isadrak/SDE-Station/boitier/stl/sde-corps.stl

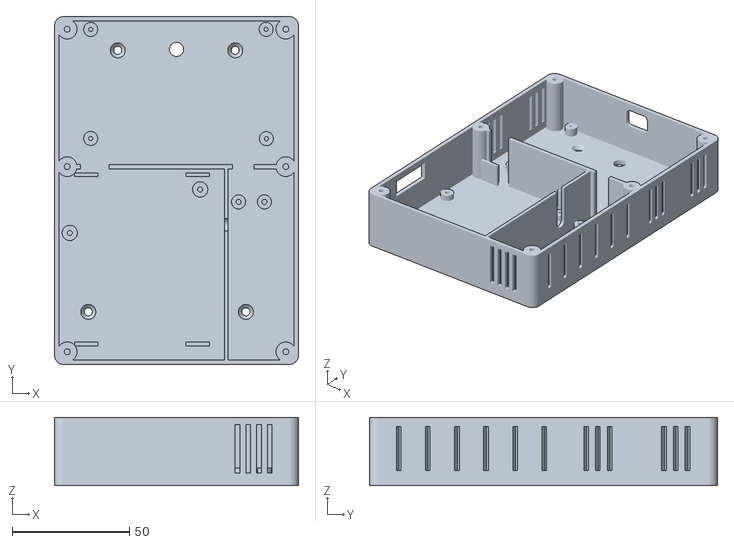
[picture p15: CAD file, 2026-10-29]
boitier/stl/sde-corps.stl
103.8 x 148.1 x 29.1
