isadrak/SDE-Station/boitier/stl/sde-socle.stl

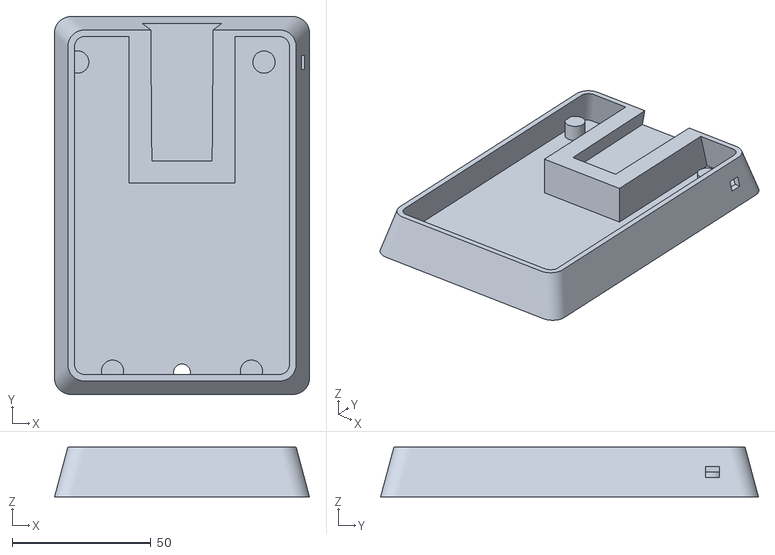
[picture p16: CAD file, 2026-10-29]
boitier/stl/sde-socle.stl
91.8 x 136.1 x 18.0
