isadrak/SDE-Station/boitier/stl/sde-pied.stl

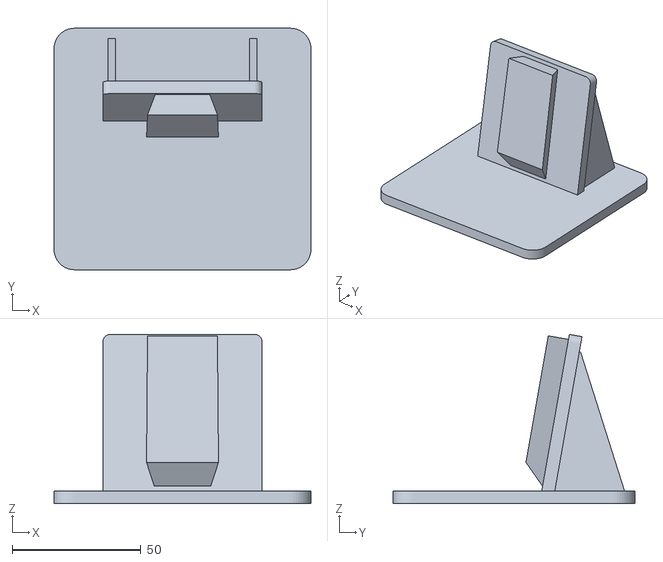
[picture p17: CAD file, 2026-10-25]
boitier/stl/sde-pied.stl
100.0 x 94.0 x 65.9
