isadrak/SDE-Station/boitier/stl/sde-capot.stl

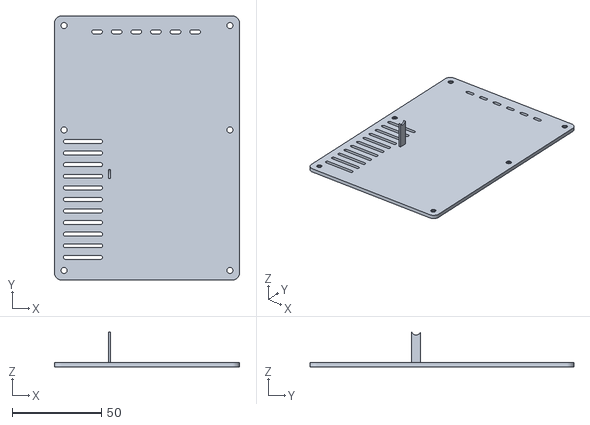
[picture p18: CAD file, 2026-10-25]
boitier/stl/sde-capot.stl
103.8 x 148.1 x 19.5
