isadrak/SDE-Station/boitier/stl/sde-support.stl

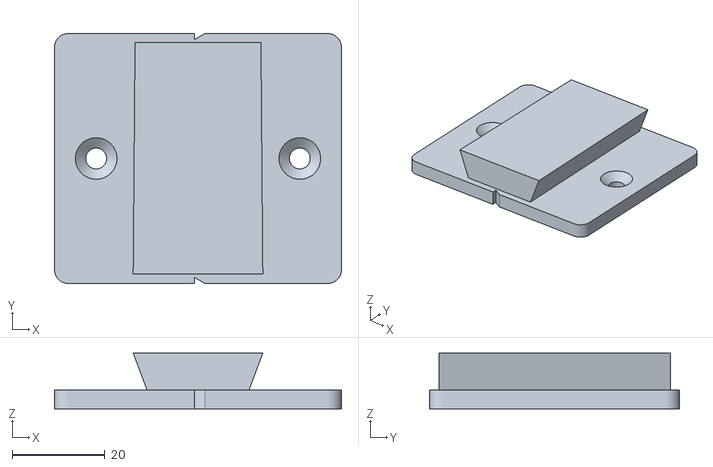
[picture p19: CAD file, 2026-10-25]
boitier/stl/sde-support.stl
62.0 x 54.0 x 12.0
