isadrak/SDE-Station/(commit log)

2026-10-25 SDE : station de diagnostic environnemental (firmware 0.9.8, appli, Android, boîtier)
    [sde-boitier.scad, sde-capot.stl, sde-corps.stl, sde-socle.stl, sde-support.stl]
2026-10-25 CI : erreurs de compilation affichées en annotations
2026-10-25 gen_assets : crée src/web/ s'il n'existe pas
2026-10-25 Firmware : versions des bibliothèques figées (taille du programme)
2026-10-25 CI : compilation avec arduino-cli (même chaîne que les binaires publiés)
2026-10-25 Compilation par firmware/build.sh (arduino-cli), APK joint aux Releases
2026-10-25 CI : notes de Release
2026-10-25 Captures refaites sans la barre d'installation
2026-10-25 README : schéma, routage et vue 3D de la carte KiCad
2026-10-25 README : précision sur la carte
2026-10-25 Images de la carte retouchées (fond retiré, recadrage, schéma compacté)
2026-10-25 Schéma : PWR_FLAG retirés de l'image
2026-10-25 Boîtier refait avec les vraies cotes et pied de table
    Carte tournée (USB en haut), SDS011 mesuré avec sortie dans la paroi
    gauche, chambre d'air frais à droite (buse et BME680), pied de table
    avec le même rail que le support mural.
    [sde-boitier.scad, sde-capot.stl, sde-corps.stl, sde-pied.stl, sde-socle.stl, sde-support.stl]
2026-10-25 Boîtier : trous du BME680 à 6 mm du bord (mesuré)
    [sde-boitier.scad, sde-corps.stl]
2026-10-25 Boîtier : socle imprimé côté plein, biseau sous le rail du pied
    Vérifié au slicer : aucune pièce ne demande de supports.
    [sde-boitier.scad, sde-pied.stl, sde-socle.stl]
2026-10-25 Boîtier : vis M3 directement dans le plastique (sans inserts)
    Option inserts = true pour revenir aux inserts laiton.
    [sde-boitier.scad, sde-corps.stl, sde-socle.stl]
2026-10-29 Boîtier : trou du câble LED déplacé, il chevauchait une vis du socle
    Signalé par l'imprimeur : le fraisage de la vis du socle en haut à droite
    touchait le trou de 6 mm du câble de la bande LED. Le trou passe au centre.
    [sde-boitier.scad, sde-corps.stl, sde-socle.stl]
2026-11-02 Docs : README, guide et notes du boîtier relus et simplifiés
    Guide renuméroté, mentions de versions intermédiaires retirées, notes du
    boîtier réécrites en documentation de projet. Bande LED commandée.
    [sde-boitier.scad]
2026-11-07 Particules : démarrage, pics isolés et air humide écartés de la note [release]
    - Appli : les 10 premières minutes après le démarrage, les pics isolés
    (filtre de Hampel sur 7 mesures) et les mesures à 75 % d'humidité ou
    plus restent affichés mais ne comptent plus dans la note ni dans la
    bande des 24 h. NowCast provisoire calculé sur la médiane. États
    « Stabilisation », « Pic passager », « Faussée par l'humidité ».
    - Firmware 0.9.9 : même règle pour la lumière murale (médiane des 3
    dernières mesures, démarrage et air humide ignorés).
    - Service worker sde-v14, guide et README à jour.
2026-11-07 Graphique des particules : courbe continue, barre de période opaque [release]
    - Les mesures du SDS011 (une par cycle) étaient coupées en points isolés
    dans l'historique : le seuil de trou suit maintenant le cycle.
    - Plus de points sur la courbe, sauf pour une mesure isolée.
    - Barre de période collante opaque : les étiquettes des graphiques ne
    passent plus dessous.
    - Firmware 0.9.10 (appli embarquée), service worker sde-v15.
2026-11-12 Bande LED : nombre de LED réglable dans l'appli, démarrage doux
2026-11-12 Bande LED : extinction de toutes les LED au démarrage, guide de câblage [release]
2026-11-12 Firmware 0.9.11 : bande LED réglable et éteinte au démarrage [release]
2026-11-12 Firmware 0.9.12 : bande LED coupée après des chutes de tension répétées [release]
2026-11-12 Firmware 0.9.13 : animations de la bande LED [release]
2026-11-12 Firmware 0.9.14 : animations LED plus douces, aération alignée sur l'appli, envoi RMT fiabilisé [release]
2026-11-12 Firmware 0.9.15 : barre de mise à jour sans ralentir l'écriture en flash [release]
2026-11-12 Firmware 0.9.18 : mise à jour par Wi-Fi de nouveau rapide [release]
2026-11-12 Firmware 0.9.21 : lumière d'ambiance sans powf, taille vérifiée à la compilation [release]
2026-11-13 Firmware 0.9.23 : toute la bande respire doucement [release]
2026-11-13 Firmware 0.9.24 : accueil plus soigné (carte principale sombre teintée par la note, ombres et boutons en relief) [release]
    Feuille de style minifiée à l'intégration dans le firmware pour ne pas grossir le binaire.
2026-11-13 Firmware 0.9.25 : respiration plus douce et nuances de teinte par LED [release]
2026-11-13 Firmware 0.9.27 : nuances qui annoncent la note suivante à l'approche du seuil [release]
